dtc245010034-rgb/Home-Garden-An-IoT-AI-System-for-Automated-Plant-Care-last/(commit log)

2026-08-06 Smart Home Garden v2.2 — IoT + AI tự động chăm sóc cây
    Hệ thống hai tầng: ESP32 đọc cảm biến và điều khiển bơm theo ngưỡng, Raspberry
    Pi 5 chụp ảnh lá gửi Gemini Vision rồi kết hợp với độ ẩm đất để ra quyết định
    qua 5 mức ưu tiên. Dashboard Flask trong LAN, lưu trữ SQLite WAL.
    Sửa các lỗi tích hợp trước khi công khai:
    - main.py không gửi PING dù firmware v2.1 yêu cầu 10 giây/lần. Vì
    send_command() lọc lệnh trùng, LOCK_IDLE ban đêm chỉ gửi một lần rồi im,
    nên sau 60 giây watchdog ESP32 nổ oan và quay về AUTO — Time Guard, khoá
    thối rễ và override tay đều b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
2026-08-06 Tách firmware thành firmware/v1 và firmware/v2
    Hai file .ino nằm chung một thư mục khiến Arduino IDE cố biên dịch cả hai và
    báo lỗi trùng hàm. Mỗi phiên bản nay có thư mục riêng, tên file .ino trùng tên
    thư mục đúng chuẩn sketch của Arduino nên mở thẳng là chạy được:
    _smart_garden_wifimanager.ino -> firmware/v1/v1.ino (bản gốc, không nạp)
    smart_garden_wifimanager_v2.ino -> firmware/v2/v2.ino (v2.1, bản để nạp)
    Thêm firmware/README.md: hướng dẫn nạp, danh sách thư viện Arduino cần cài,
    bảng khác biệt v1 -> v2.1, và cách cấu hình WiFi qua WiFiManager.
    Cập nhật đường dẫn trong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
2026-08-06 Sửa hidden bị vô hiệu hoá làm 4 băng cảnh báo hiện thường trực
    Mở dashboard lên là thấy ngay cả 4 băng cảnh báo dù chưa có cảnh báo nào —
    trong đó một băng đỏ chỉ có mỗi icon, không có chữ. Biểu đồ rỗng cũng hiện
    chồng lên dòng "Đang thu thập dữ liệu...", khung ảnh hiện icon ảnh vỡ.
    Nguyên nhân: thuộc tính hidden của HTML chỉ hoạt động nhờ luật
    [hidden]{display:none} nằm trong stylesheet MẶC ĐỊNH của trình duyệt. Trong
    cascade, mọi khai báo của tác giả đều thắng stylesheet trình duyệt bất kể độ
    đặc hiệu, nên bốn khai báo display sau đã vô hi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
2026-08-06 Đối chiếu báo cáo cuối kỳ với hệ thống; bỏ firmware v1
    Rà soát từng số liệu và từng phát biểu trong SIC_IoT_Final_Report với mã nguồn
    đang chạy. Tìm được 22 điểm lệch, áp 49 phép sửa vào .docx mà không đụng tới
    định dạng template. Đáng kể nhất:
    - Trọng số làm mịn quang trở ghi ngược (báo cáo: mới 0.7 / cũ 0.3; code:
    cũ 0.7 / mới 0.3).
    - Trường mode được mô tả có giá trị LOCKED, firmware chỉ phát AUTO hoặc MANUAL.
    - Bảng số dòng nguồn đang mô tả firmware v1 (355) chứ không phải v2 (432).
    - Bảng chính sách cục bộ bỏ mất thứ tự ưu tiên của decid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
2026-08-06 Viết lại tài liệu theo văn phong nộp báo cáo; vẽ PING và watchdog vào sơ đồ
    Sơ đồ 1 thêm nút checkSerialWatchdog() ở tầng thiết bị và nhịp PING từ
    decision_loop, tô cùng màu với normalize_ai_result vì cả hai đều là lớp chặn.
    Sơ đồ 4 thêm vòng lặp PING trong suốt thời gian giữ lệnh, kèm một sequence thứ
    hai cho nhánh hỏng: Pi chết giữa chừng, PING ngừng, watchdog nhả relay sau 60
    giây. Cả 9 khối mermaid đã qua mermaid.parse() bằng trình dựng thật; khối
    sequence ban đầu lỗi vì dấu chấm phẩy trong Note bị hiểu là dấu kết câu lệnh.
    Viết lại README.md, SETUP_PI5.md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
2026-08-06 Xuất PNG 8 sơ đồ ra doc/hinh, scale 3x
    Dựng bằng Chrome headless thay vì cài mermaid-cli, vốn kéo theo Puppeteer và một
    bản Chromium riêng. Script đo kích thước SVG ở lượt đầu rồi chụp đúng khung đó ở
    --force-device-scale-factor=3 nên ảnh không thừa lề và không bị cắt. Kèm luôn
    doc/mkpng.py để xuất lại được sau này.
    Sửa một lỗi layout phát hiện khi xem ảnh: hai cạnh VAL->DL và API->DL cùng đổ vào
    decision_loop nên dagre đặt hai nhãn chồng lên nhau, chữ đè chữ. Rút ngắn nhãn
    không giải quyết được vì đây là va chạm vị trí, phải bỏ hẳn nhãn của một cạnh.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
2026-08-06 Bỏ emoji khỏi toàn bộ sơ đồ và xuất lại PNG
    16 chỗ trong 7 sơ đồ. Nhãn nút chỉ xoá icon và khoảng trắng thừa. Hai chỗ dấu
    tick mang nghĩa thì thay bằng chữ: "enum ✓ · conf 95 ≥ 40 ✓ · có cây ✓" thành
    "enum hợp lệ · conf 95 ≥ 40 · có cây trong khung", và "95% ≥ 70% ✓ và ngoài
    cooldown ✓" thành "95% ≥ 70% và ngoài cooldown".
    Thông tin không mất đi: các mức ưu tiên vẫn phân biệt bằng màu nền, vốn mới là
    mã hoá thị giác thật sự của hình, icon chỉ trang trí. Giờ khớp với README và
    SETUP_PI5 vừa bỏ icon.
    Sáu PNG đổi nội dung, hai file 04b và 07 không đổi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
2026-08-06 Thêm script chèn ảnh sơ đồ vào Final Report
    doc/chen_anh.py dùng python-docx, tìm ô bảng chứa chuỗi placeholder, xoá chữ và
    chèn ảnh canh giữa với bề rộng đúng bằng khung nội dung A4 (6.27 in). Ảnh nào
    cao quá 8.4 in thì ràng buộc theo chiều cao để không tràn sang trang sau.
    Sơ đồ 4b chưa có placeholder trong báo cáo nên script nhân bản bảng hình của
    Figure 3.5 và tạo Figure 3.6 ngay sau đó.
    Hai placeholder cố ý để trống: ảnh chụp dashboard phải chụp lúc hệ có dữ liệu
    thật (bản báo cáo tự dặn tránh chụp bảng rỗng), và ảnh nhóm.
    Nhận đối số thứ ba để ghi ra f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
2026-08-06 Thêm script tạo bản báo cáo tiếng Việt
    doc/dich_bao_cao.py chứa bản dịch 662 đơn vị văn bản, tra theo chỉ số của lần
    trích xuất và đối chiếu nguyên bản trước khi ghi đè nên không lệch chỉ số. Ảnh,
    bảng biểu và style đoạn văn giữ nguyên: đếm lại style cho kết quả giống hệt bản
    gốc (7 Heading 1, 15 Heading 2, 30 Heading 3, 37 List Paragraph).
    109 đơn vị cố ý giữ nguyên: định danh mã nguồn (WATER_ON, MIST_LOCK, PING,
    normalize_ai_result), tên hằng số, tên chân GPIO, mã mục tiêu O1-O7, mã kiểm
    thử T1-T6, mã mốc M1-M6, số và đơn vị.
    Ghi chú bản quyền Samsung gi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
2026-08-06 Bộ kiểm thử 45 bài, endpoint sức khoẻ, và vá lỗ hổng nuốt lỗi
    Phần lớn chức năng chỉ kích hoạt trong tình huống hiếm không gọi ra được theo ý
    muốn. Nhưng mọi điều kiện đó khi vào phần mềm chỉ còn là dữ liệu: trạng thái AI
    là một dict, độ ẩm đất là một số, ban đêm là hàm trả boolean, ESP32 là object có
    write và readline. Bộ test dựng lại toàn bộ, chạy trong một giây, không cần phần
    cứng, API key hay mạng.
    Phủ: 8 dạng phản hồi hỏng của mô hình và 4 dạng hợp lệ, đủ 10 ô ma trận fusion,
    thứ tự năm mức ưu tiên, lọc lệnh trùng, nhịp P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
